AlbertUngureanu/MotionController_ScorbotER-VII/README.md

# MotionController_ScorbotER-VII

This represents the project that I developed for my undergraduate thesis.
