AlbertUngureanu/MotionController_ScorbotER-VII/src/python_app/assets/frame0/image_1.png

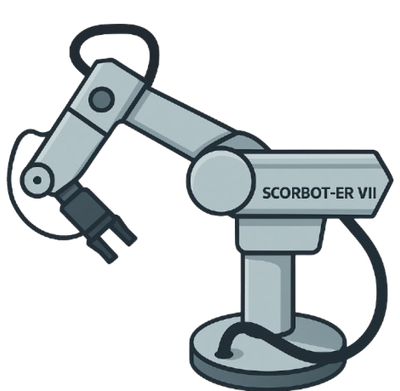
src/python_app/assets/frame0/image_1.png
